richardsuan/Mini_Sumo/README.md

# Mini_Sumo
Este es el diseno de un mini-sumo con un tamano de 96mm de ancho con un largo de 98,11mm este sumo usa dos motoreductores de 6v a 500rpm con un tamano de 12x24mm estos son controlados por un modulo l298n
en este prototipo se usa el sensor de proximidad e18-d80nk que tiene un rango que va desde los 10cm a los 80 cm y para sensar la marca del final de la pista se usa un modulo de infra rojo  infrarojo modelo sfl
y para la alimentacion del sumo se usa una bateria de 5v con una alta corriente todo esto va a ser controlado con una micro stm32f103c8t6
