richardsuan/Mini_Sumo/codigo/sumobot/techo1.stl

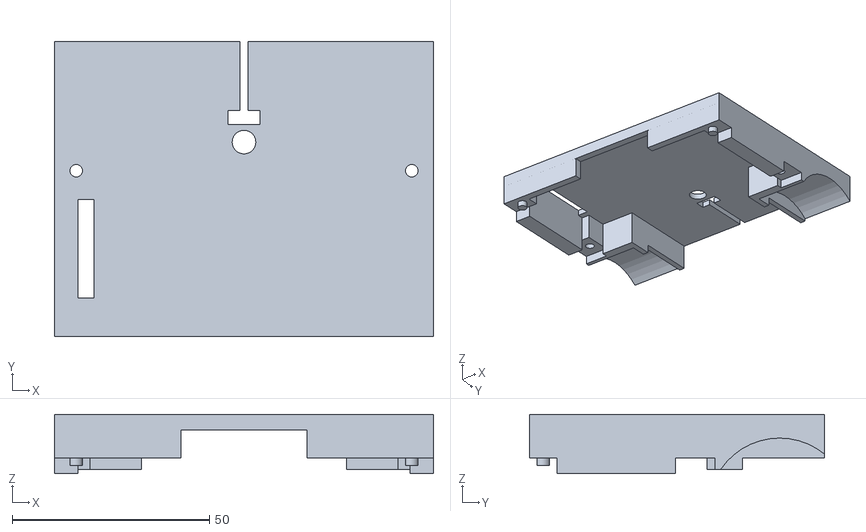
[picture p17: CAD file, 2019-05-15]
codigo/sumobot/techo1.stl
96.0 x 74.8 x 15.0
