richardsuan/Mini_Sumo/codigo/sumobot/motores.stl

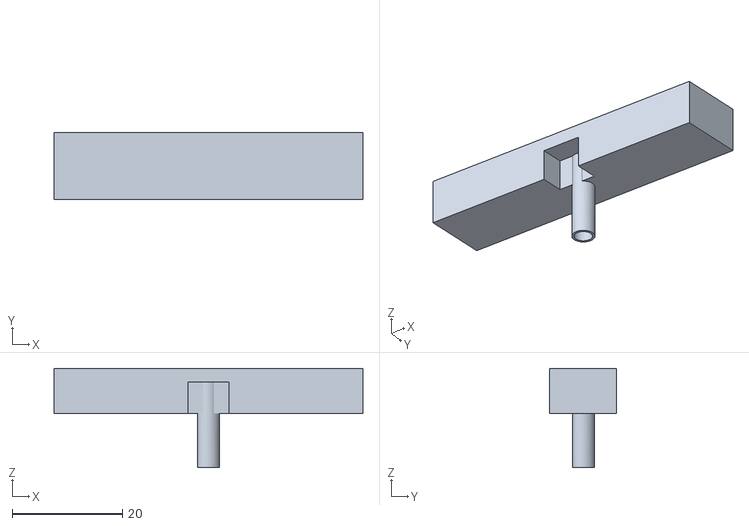
[picture p18: CAD file, 2019-05-15]
codigo/sumobot/motores.stl
56.0 x 12.2 x 18.0
