richardsuan/Mini_Sumo/codigo/sumobot/techo2.stl

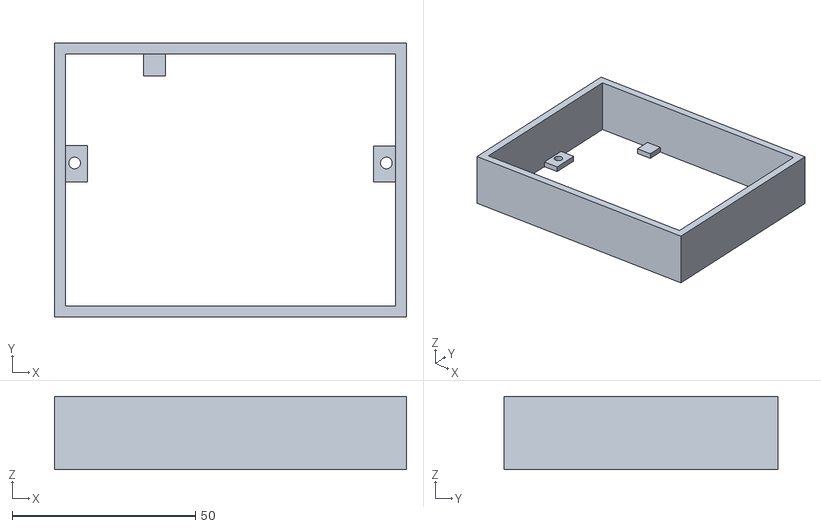
[picture p19: CAD file, 2019-05-15]
codigo/sumobot/techo2.stl
96.0 x 74.8 x 20.0
