richardsuan/Mini_Sumo/esquematico/Schematic_embebidos-PWM_20190508081315.pdf

3.3V

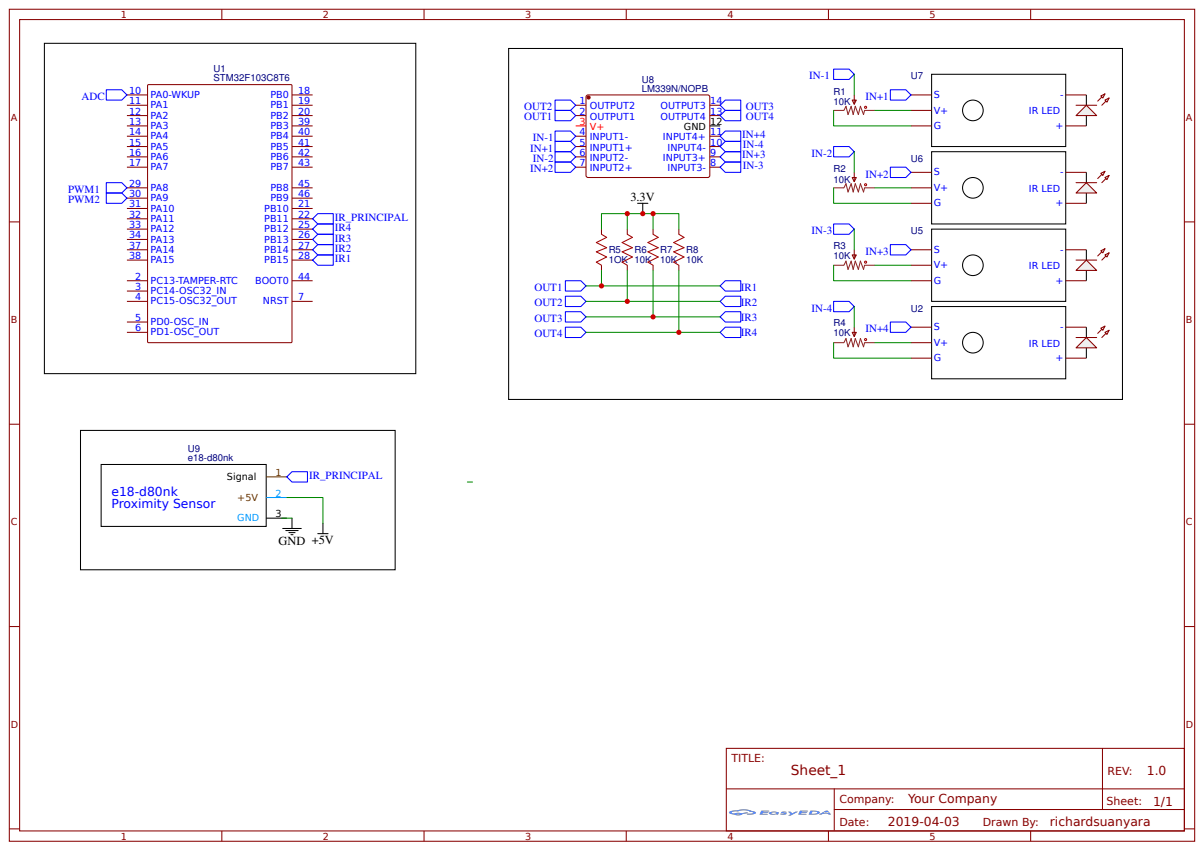
[picture p20: page 1]

## VCC

## VCC

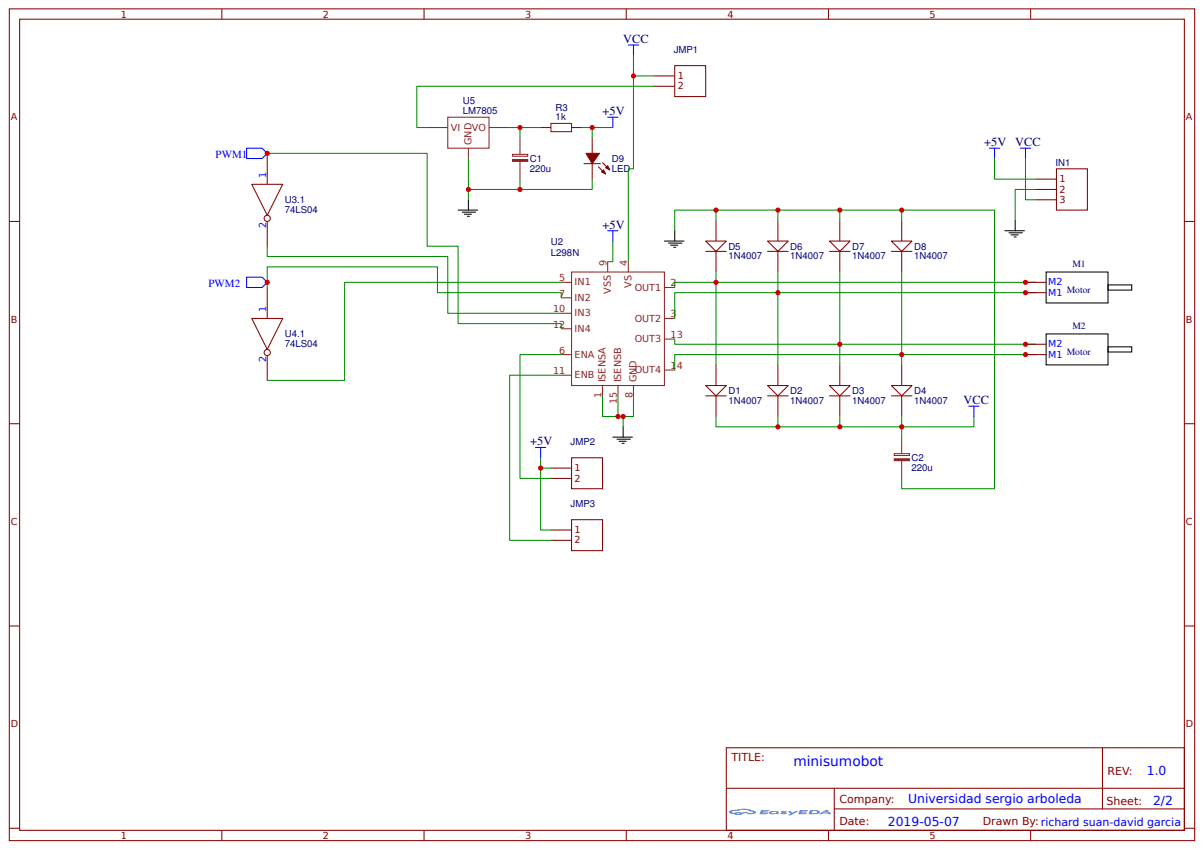
[picture p21: page 2]

Company: Universidad sergio arboleda

Drawn By: richard suan-david garcia
