richardsuan/Mini_Sumo/codigo/sumobot/Src/main.c

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

/* Includes ------------------------------------------------------------------*/
#include "main.h"

/* USER CODE BEGIN PTD */
typedef enum{
	IR_BLANCO=0,
	IR_NEGRO
}ST_IR_PISO;
typedef enum{
	IR_ON=0,
	IR_OFF

}ST_IR_PROXIMIDAD;
typedef enum{
	M_RUN_MAX_DER=0,
	M_RUN_MAX_IZQ,
	M_STOP,
	M_RUN_MIN_DER,
	M_RUN_MIN_IZQ,
	M_RUN_MID_IZQ,
	M_RUN_MID_DER,
	M_STB
}ST_MOTOR;

typedef enum{
	LOC_CHECK=0,
	LOC_STB
}ST_LOC;
typedef enum{
	LOC_CHECKING=0,
	LOC_MOVE,
	LOC_ST
}ST_SEARCH;
typedef enum{
	B_COUNT=0,
	B_STB
}ST_BOTON;
enum{
	T_MOTOR=0,
	T_MOTOR2,
	T_BOTON,
	T_TURN,
	T_EMPUJE,
	timers
};
uint8_t aux=0;

/* USER CODE END PTD */

ADC_HandleTypeDef hadc1;

TIM_HandleTypeDef htim1;
TIM_HandleTypeDef htim2;

/* USER CODE BEGIN PV */
ST_IR_PISO IR1,IR2,IR3,IR4;
ST_MOTOR M1,M2;
ST_LOC LOC;
ST_IR_PROXIMIDAD SP;
ST_SEARCH buscar;
ST_BOTON B1;
volatile uint16_t i;
volatile int TIMERS[timers];
/* USER CODE END PV */

void SystemClock_Config(void);
static void MX_GPIO_Init(void);
static void MX_TIM2_Init(void);
static void MX_TIM1_Init(void);
static void MX_ADC1_Init(void);
/* USER CODE BEGIN PFP */
void IR1_process();
void SP_process();//
void IR2_process();
void IR3_process();
void IR4_process();
void M1_process();
void M2_process();
void LOC_process();
void B1_process();
/* USER CODE END PFP */

/**
  * @brief  The application entry point.
  * @retval int
  */
int main(void)
{
  /* MCU Configuration--------------------------------------------------------*/

  /* Reset of all peripherals, Initializes the Flash interface and the Systick. */
  HAL_Init();

  /* Configure the system clock */
  SystemClock_Config();

  /* Initialize all configured peripherals */
  MX_GPIO_Init();
  MX_TIM2_Init();
  MX_TIM1_Init();
  MX_ADC1_Init();
  /* USER CODE BEGIN 2 */
  HAL_TIM_Base_Start_IT(&htim2);
  HAL_TIM_PWM_Start(&htim1,TIM_CHANNEL_2);
  HAL_TIM_PWM_Start(&htim1,TIM_CHANNEL_1);
  IR1=IR_NEGRO,IR2=IR_NEGRO,IR3=IR_NEGRO,IR4=IR_NEGRO;
  M1=M_STOP,M2=M_STOP;
  SP=IR_ON;
  LOC=LOC_CHECK;
  B1=B_STB;
  /* USER CODE END 2 */

  /* Infinite loop */
  /* USER CODE BEGIN WHILE */
  while (1)
  {
    /* USER CODE END WHILE */

    /* USER CODE BEGIN 3 */
	  if(aux==0){
		  B1_process();
		  M2=M_STOP;
		  M1=M_STOP;
		  M1_process();
		  M2_process();
	  }else if(aux==1){
		  IR1_process();
		  IR2_process();
		  IR3_process();
		  IR4_process();

		  M1_process();
		  M2_process();

		  LOC_process();
		  SP_process();
	  }
  }
  /* USER CODE END 3 */
}

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
/* USER CODE BEGIN 4 */

void HAL_TIM_PeriodElapsedCallback(TIM_HandleTypeDef *htim){  //timer cada 100us
	if(htim->Instance==TIM2){
		for(i=0;i<timers;i++){
			if(TIMERS[i]!=0&& i<4){
				TIMERS[i]--;
			}else{
				TIMERS[i]++;
			}
		}
	}
}

void IR1_process(){
	switch(IR1){
		case IR_BLANCO:
			if(HAL_GPIO_ReadPin(GPIOB,GPIO_PIN_12)==1){
				IR1=IR_NEGRO;
			}
			break;
		case IR_NEGRO:
			if(HAL_GPIO_ReadPin(GPIOB,GPIO_PIN_12)==0){
				IR1=IR_BLANCO;
			}
			break;
	}
}

void SP_process(){
	switch(SP){
	case(IR_ON):
		if(HAL_GPIO_ReadPin(GPIOB,GPIO_PIN_11)==1){
			//NO HAY NADIE
			HAL_GPIO_WritePin(GPIOC,GPIO_PIN_13, GPIO_PIN_SET);
			SP=IR_OFF;

		}
			break;
	case(IR_OFF):
		if(HAL_GPIO_ReadPin(GPIOB,GPIO_PIN_11)==0){
			HAL_GPIO_WritePin(GPIOC,GPIO_PIN_13, GPIO_PIN_RESET);
			TIMERS[T_EMPUJE]=0;
			SP=IR_ON;
		}
			break;
	}
}

void IR2_process(){
	switch(IR2){
		case IR_BLANCO:
			if(HAL_GPIO_ReadPin(GPIOB,GPIO_PIN_13)==1){
				IR2=IR_NEGRO;
			}
			break;
		case IR_NEGRO:
			if(HAL_GPIO_ReadPin(GPIOB,GPIO_PIN_13)==0){
				IR2=IR_BLANCO;
			}
			break;
	}
}

void IR3_process(){
	switch(IR3){
		case IR_BLANCO:
			if(HAL_GPIO_ReadPin(GPIOB,GPIO_PIN_14)==1){
				IR3=IR_NEGRO;
			}
			break;
		case IR_NEGRO:
			if(HAL_GPIO_ReadPin(GPIOB,GPIO_PIN_14)==0){
				IR3=IR_BLANCO;
			}
			break;
	}
}

void IR4_process(){
	switch(IR4){
		case IR_BLANCO:
			if(HAL_GPIO_ReadPin(GPIOB,GPIO_PIN_15)==1){
				IR4=IR_NEGRO;
			}
			break;
		case IR_NEGRO:
			if(HAL_GPIO_ReadPin(GPIOB,GPIO_PIN_15)==0){
				IR4=IR_BLANCO;
			}
			break;
	}
}

void M1_process(){
	switch(M1){
		case M_STB:
			//Do nothing
			break;
		case M_STOP:
			__HAL_TIM_SET_COMPARE(&htim1,TIM_CHANNEL_1,5000);
			M1=M_STB;
			break;
		case M_RUN_MIN_DER:
			__HAL_TIM_SET_COMPARE(&htim1,TIM_CHANNEL_1,4000);
			M1=M_STB;
			break;
		case M_RUN_MID_DER:
			__HAL_TIM_SET_COMPARE(&htim1,TIM_CHANNEL_1,2750);
			M1=M_STB;
			break;
		case M_RUN_MAX_DER:
			__HAL_TIM_SET_COMPARE(&htim1,TIM_CHANNEL_1,1000);
			M1=M_STB;
			break;
		case M_RUN_MIN_IZQ:
			__HAL_TIM_SET_COMPARE(&htim1,TIM_CHANNEL_1,6000);
			M1=M_STB;
			break;
		case M_RUN_MID_IZQ:
			__HAL_TIM_SET_COMPARE(&htim1,TIM_CHANNEL_1,7250);
			M1=M_STB;
			break;
		case M_RUN_MAX_IZQ:
			__HAL_TIM_SET_COMPARE(&htim1,TIM_CHANNEL_1,9000);
			M1=M_STB;
			break;
	}
}

void M2_process(){
	switch(M2){
		case M_STB:
			//Do nothing
			break;
		case M_STOP:
			__HAL_TIM_SET_COMPARE(&htim1,TIM_CHANNEL_2,5000);
			M2=M_STB;
			break;
		case M_RUN_MIN_DER:
			__HAL_TIM_SET_COMPARE(&htim1,TIM_CHANNEL_2,4000);
			M2=M_STB;
			break;
		case M_RUN_MID_DER:
			__HAL_TIM_SET_COMPARE(&htim1,TIM_CHANNEL_2,2750);
			M2=M_STB;
			break;
		case M_RUN_MAX_DER:
			__HAL_TIM_SET_COMPARE(&htim1,TIM_CHANNEL_2,1000);
			M2=M_STB;
			break;
		case M_RUN_MIN_IZQ:
			__HAL_TIM_SET_COMPARE(&htim1,TIM_CHANNEL_2,6000);
			M2=M_STB;
			break;
		case M_RUN_MID_IZQ:
			__HAL_TIM_SET_COMPARE(&htim1,TIM_CHANNEL_2,7250);
			M2=M_STB;
			break;
		case M_RUN_MAX_IZQ:
			__HAL_TIM_SET_COMPARE(&htim1,TIM_CHANNEL_2,9000);
			M2=M_STB;
			break;
	}
}

void LOC_process(){
	switch(LOC){
		case LOC_CHECK:
			if(IR1==IR_BLANCO && IR2==IR_NEGRO){
				M1=M_RUN_MIN_IZQ;
				M2=M_RUN_MID_DER;
			}else if(IR2==IR_BLANCO && IR1==IR_NEGRO){
				M2=M_RUN_MIN_IZQ;
				M1=M_RUN_MID_DER;
			}else if(IR1==IR_BLANCO && IR2==IR_BLANCO){
				M1=M_RUN_MAX_IZQ;
				M2=M_RUN_MAX_IZQ;
				TIMERS[T_MOTOR]=7000;
				LOC=LOC_STB;
			}else if(IR3==IR_BLANCO && IR4==IR_NEGRO){
				M1=M_RUN_MIN_IZQ;
				M2=M_RUN_MID_DER;
			}else if(IR4==IR_BLANCO && IR3==IR_NEGRO){
				M1=M_RUN_MIN_IZQ;
				M2=M_RUN_MID_DER;
			}else if(IR3==IR_BLANCO && IR4==IR_BLANCO){
				M1=M_RUN_MAX_DER;
				M2=M_RUN_MAX_DER;
				TIMERS[T_MOTOR]=7000;
				LOC=LOC_STB;
			}else if(IR1==IR_NEGRO && IR2==IR_NEGRO && IR3==IR_NEGRO && IR4==IR_NEGRO){
				if(SP==IR_OFF){
					M1=M_RUN_MID_IZQ;
					M2=M_RUN_MID_DER;
				}else if(SP==IR_ON){
					if(TIMERS[T_EMPUJE]>7500){
						M2=M_RUN_MAX_IZQ;
						M1=M_RUN_MAX_IZQ;
					}else if(TIMERS[T_EMPUJE]<=5000&&TIMERS[T_EMPUJE]>=0){
						M2=M_RUN_MID_IZQ;
						M1=M_RUN_MID_IZQ;
					}
				}
			}
			break;
		case LOC_STB:
			if(TIMERS[T_MOTOR]==0){
				LOC=LOC_CHECK;
			}
			break;
	}
}

void B1_process(){
	switch(B1){
		case B_STB:
			if(HAL_GPIO_ReadPin(GPIOB,GPIO_PIN_10)==1){
				TIMERS[T_BOTON]=50000;
				B1=B_COUNT;
			}
			break;
		case B_COUNT:
			if(TIMERS[T_BOTON]==0){
				B1=B_STB;
				aux=1;
			}
			break;
	}
}

/* USER CODE END 4 */
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
