richardsuan/Mini_Sumo/codigo/sumobot/sumobot.ioc

Mcu.UserName=STM32F103C8Tx
PA0-WKUP.Signal=ADCx_IN0
PA13.Signal=SYS_JTMS-SWDIO
PA14.Signal=SYS_JTCK-SWCLK
PA8.Signal=S_TIM1_CH1
PA9.Signal=S_TIM1_CH2
PB10.Signal=GPIO_Input
PB11.Signal=GPIO_Input
PB12.Signal=GPIO_Input
PB13.Signal=GPIO_Input
PB14.Signal=GPIO_Input
PB15.Signal=GPIO_Input
PD0-OSC_IN.Signal=RCC_OSC_IN
PD1-OSC_OUT.Signal=RCC_OSC_OUT
