richardsuan/Mini_Sumo/(commit log)

2019-05-08 agregue el esquematico y el diseno de la estructura del sumo
2019-05-15 agrego el inicio del codigo en maquinas de estadofuncionando los sensores de piso y en proceso el sensore de proximidad y se agrego en diseño final en FREEcad
    [motores.stl, techo1.stl, techo2.stl]
2019-05-17 agrego el inicio del informe en donde falta la seccion de resultados
2019-05-21 agrego la parte final del codigo y el informe
