richardsuan/Mini_Sumo/(notices)

Notices in the files:
codigo/sumobot/Src/main.c:
COPYRIGHT(c) 2019 STMicroelectronics
(C) COPYRIGHT STMicroelectronics *****END OF FILE
